LJH222-wq/zhinengxiaoche/_基于Arduino_nano的智能小车设计2V3-物料清单.pdf

焊接 顺序 | 器件名称 | 参数 | 位号 | 商城编号 | 数量 | 备注
1 | 直插电阻330Ω | 1/4W-330Ω | R9,R10,R7,R8,R11,R12 | C713986 | 6
2 | 直插电阻10KΩ | 1/4W-10kΩ | R1,R2、R4~R6,R13~R24 | C410695 | 17
3 | 发光二极管-红色 | 3mm 红色 | LED1 | C99771 | 1 | 长脚为正极
4 | 发光二极管-绿色 | 3mm 绿色 | LED4~LED7 | C330929 | 4 | 长脚为正极
5 | 发光二极管-白色 | 白色高亮 | LED2,LED3 | C331025 | 2 | 90度弯脚，长脚为正极
6 | 开关二极管 | 1N4007 | D1,D2 | C402311 | 2 | 白色竖线为负极
7 | 三极管 | S8050 | Q1 | C2931492 | 1 | 管脚较密，注意不要短路
8 | 蜂鸣器 | 16Ω-50P4.0 | Buzzer1 | C2693580 | 1 | "+"处为正极
9 | 芯片底座 | DIP-8 | U12,U13 | - | 2 | 底座缺口位置与丝印对齐
10 | 比较器芯片XD393 | LM393P | U12,U13 | C561266 | 2 | 芯片缺口位置对齐底座缺口
11 | 可调电阻 | 3296W-1-103 | RP1~RP5 | C118954 | 5 | 调节旋钮与丝印对齐
12 | 光电传感器ITR9909 | ITR9909 | U8~U11 | C53399 | 4 | 位于PCB板背面， 白色灯方向与丝印对齐
13 | 电解电容 | 100uF | C1,C2 | C19504 | 2 | 长引脚为正极，短的为负极 有白色丝印条的是负极
14 | 散热片 | 15.5*10.5*24 | U1 | C108928 | 1 | 将芯片与散热片紧靠，用KM3*4螺 丝拧紧后成为一个整体。然后插入 电路板中进行焊接
15 | 电源芯片L7805CV | L7805CV | U4 | C111887 | 1
16 | 独立按键 | 6*6*4.5 | KEY1 | C2834896 | 1
17 | 拨动开关 | SK-12E12-G5 | SW1 | C136720 | 1
18 | 电池座 | 14500*2 | P1 | - | 1 | 先将电池座用M3*6螺丝和螺母固定 在电路板上，再焊接管脚
19 | XHB2.54带扣插座2P | XHB2.54 2P | H2、H3、H5、H6 | C7429614 | 4 | 注意缺口方向
20 | 单排排母 | 2.54mm，1*15P | U7 | C2932676 | 3 | 先将Arduino nano核心板插入2个排 母，再将排母底端插入电路板中进 行焊接
21 | Arduino nano开发板 | Arduino nano | U7 | | 1
22 | 单排排母6P | 2.54mm，1*6P | BLUETOOTH | | 1 | 先焊好排母，再插入蓝牙模块（插 入时注意管脚名称对齐）
23 | 蓝牙模块 | HC-05 | BLUETOOTH | | 1
24 | 单排排母4P | 2.54mm，1*4P | H4、JP2 | | 2
25 | 超声波测距模块 | HC-SR04 | H4 | | 1
26 | 驱动芯片RZ7899 | RZ7899 | U2、U3、U5、U6 | C92373 | 4 | 圆点为第1引脚
27 | 电机排线 | XHB2.54*2P,5mm | | | 4 | 焊接时间不宜过长
28 | 电机座 | | ASS_1,ASS_2,ASS_3,ASS_4 | | 4 | 用M2*5螺丝、螺母（各8个）固定
29 | 锂电池 | 14500 | | | 2
30 | 锂电池充电器 | 4.2V/1A | | | 1
31 | 橡胶车轮 | 43mm | | | 4
32 | 直流电机 N20 | 直型，6V，100转 | | | 4
33 | 智能小车底板 | | | | 1

## 轮式智能小车物料清单
