LJH222-wq/zhinengxiaoche/(list of files, cad)

Other CAD files:
装配体2/装配体2.SLDASM
装配体2/3D外壳.SLDPRT
