LJH222-wq/zhinengxiaoche/SCH_智能小车_2025-12-19.pdf

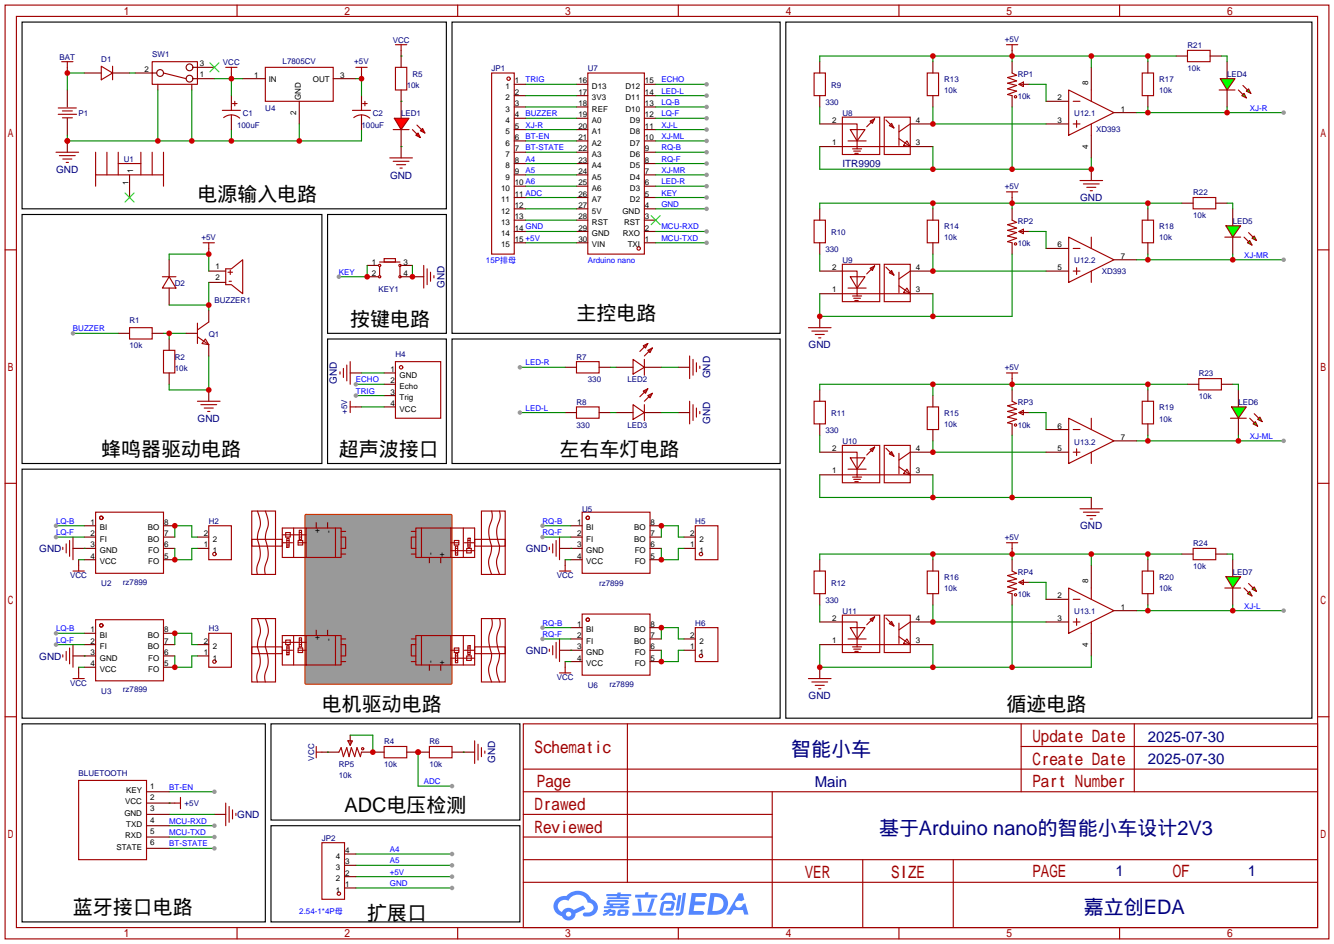
[picture p17: page 1]
