LJH222-wq/zhinengxiaoche/11号-硬件设计文件/SCH_Schematic1_2026-01-04.pdf

## 电源输入电路

10 10 11 11 12 12 13 13 14 14 15 15

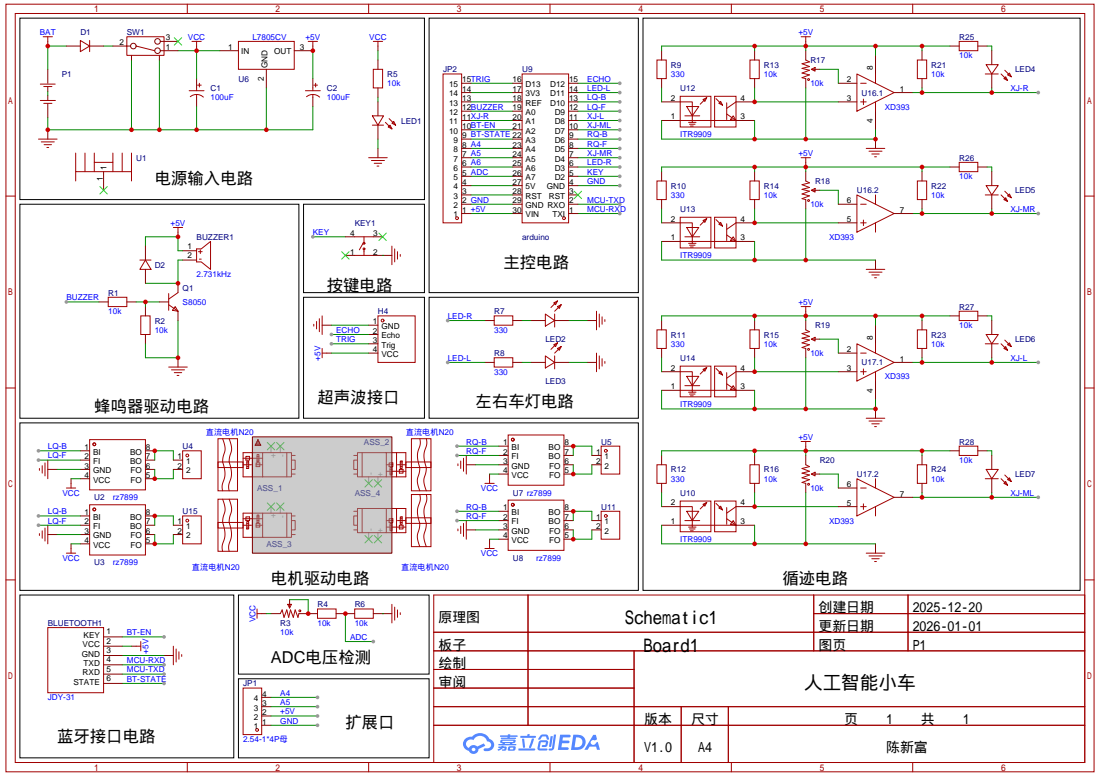
[picture p1: page 1]

原理图 | Schematic1 | 创建日期 | 2025-12-20

更新日期 | 2026-01-01

板子 | Board1 | 图页 | P1
绘制 | | 人工智能小车
审阅

V1.0 | A4 | 陈新富
