LJH222-wq/zhinengxiaoche/PCB_智能小车_2025-12-15.pdf

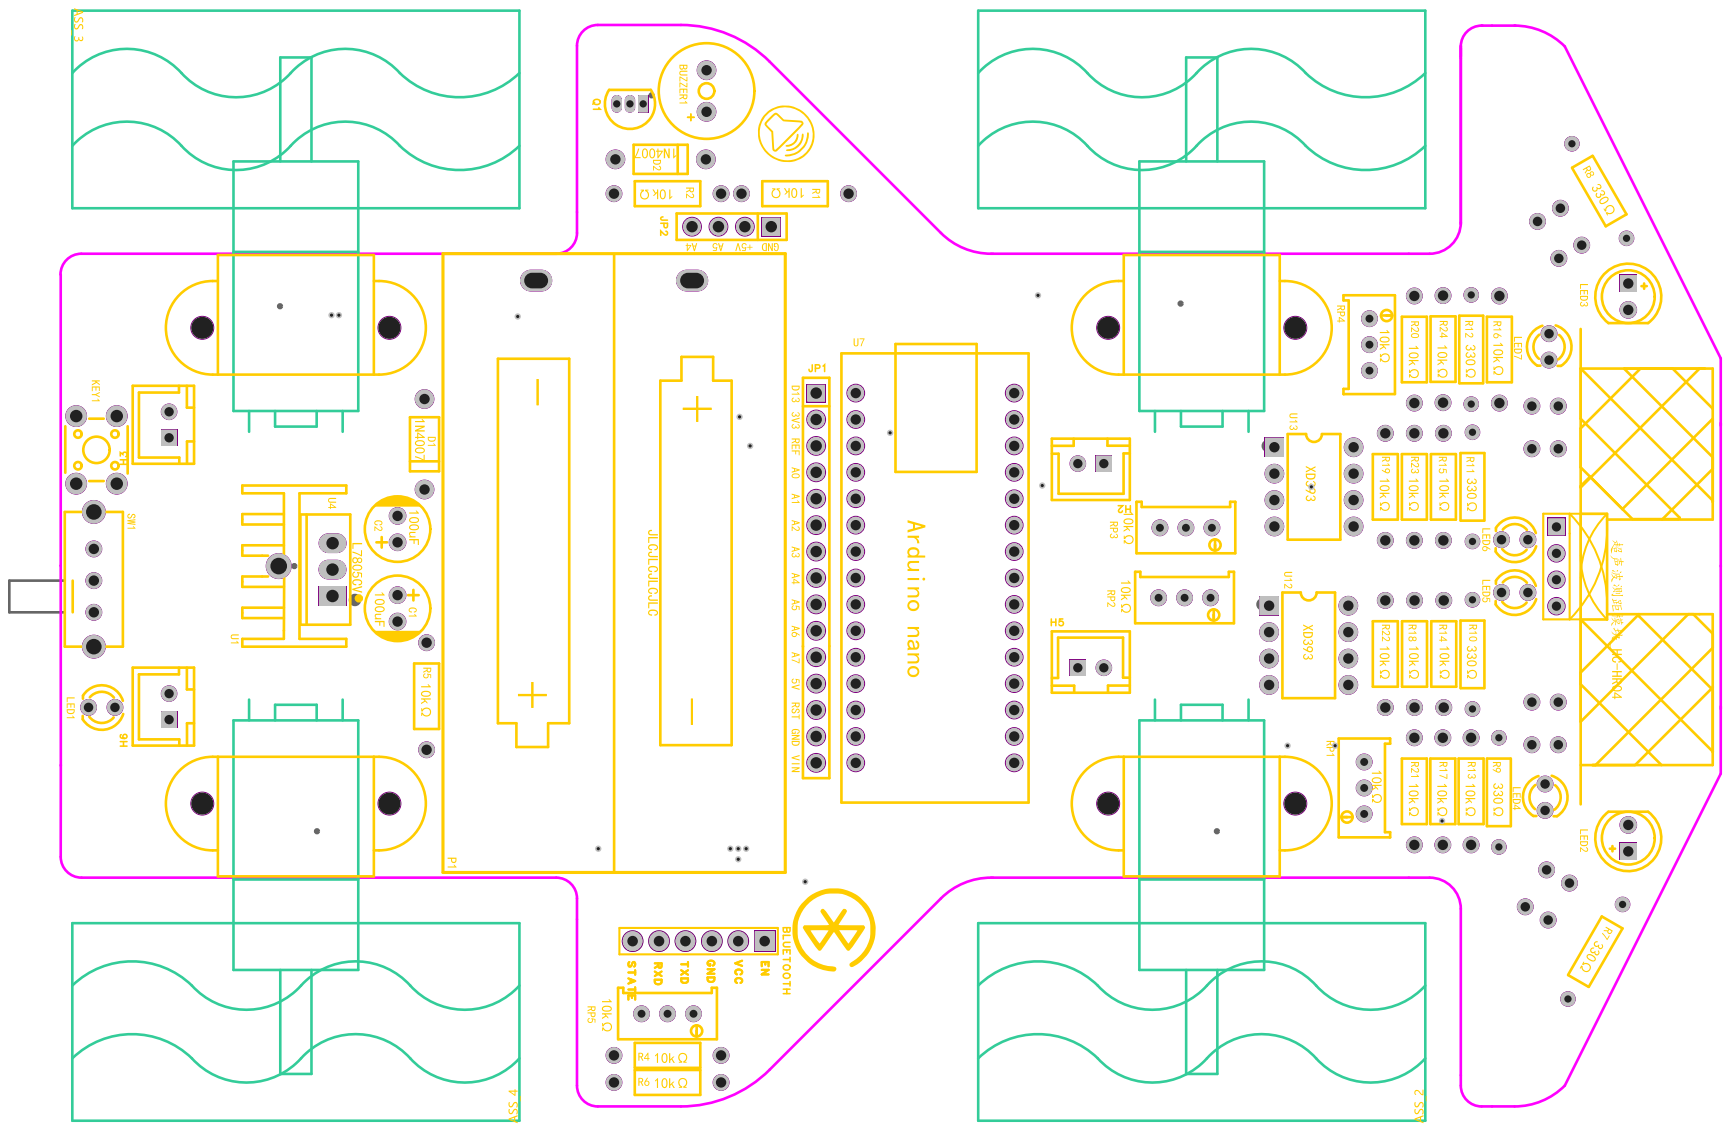
[picture p2: page 1]

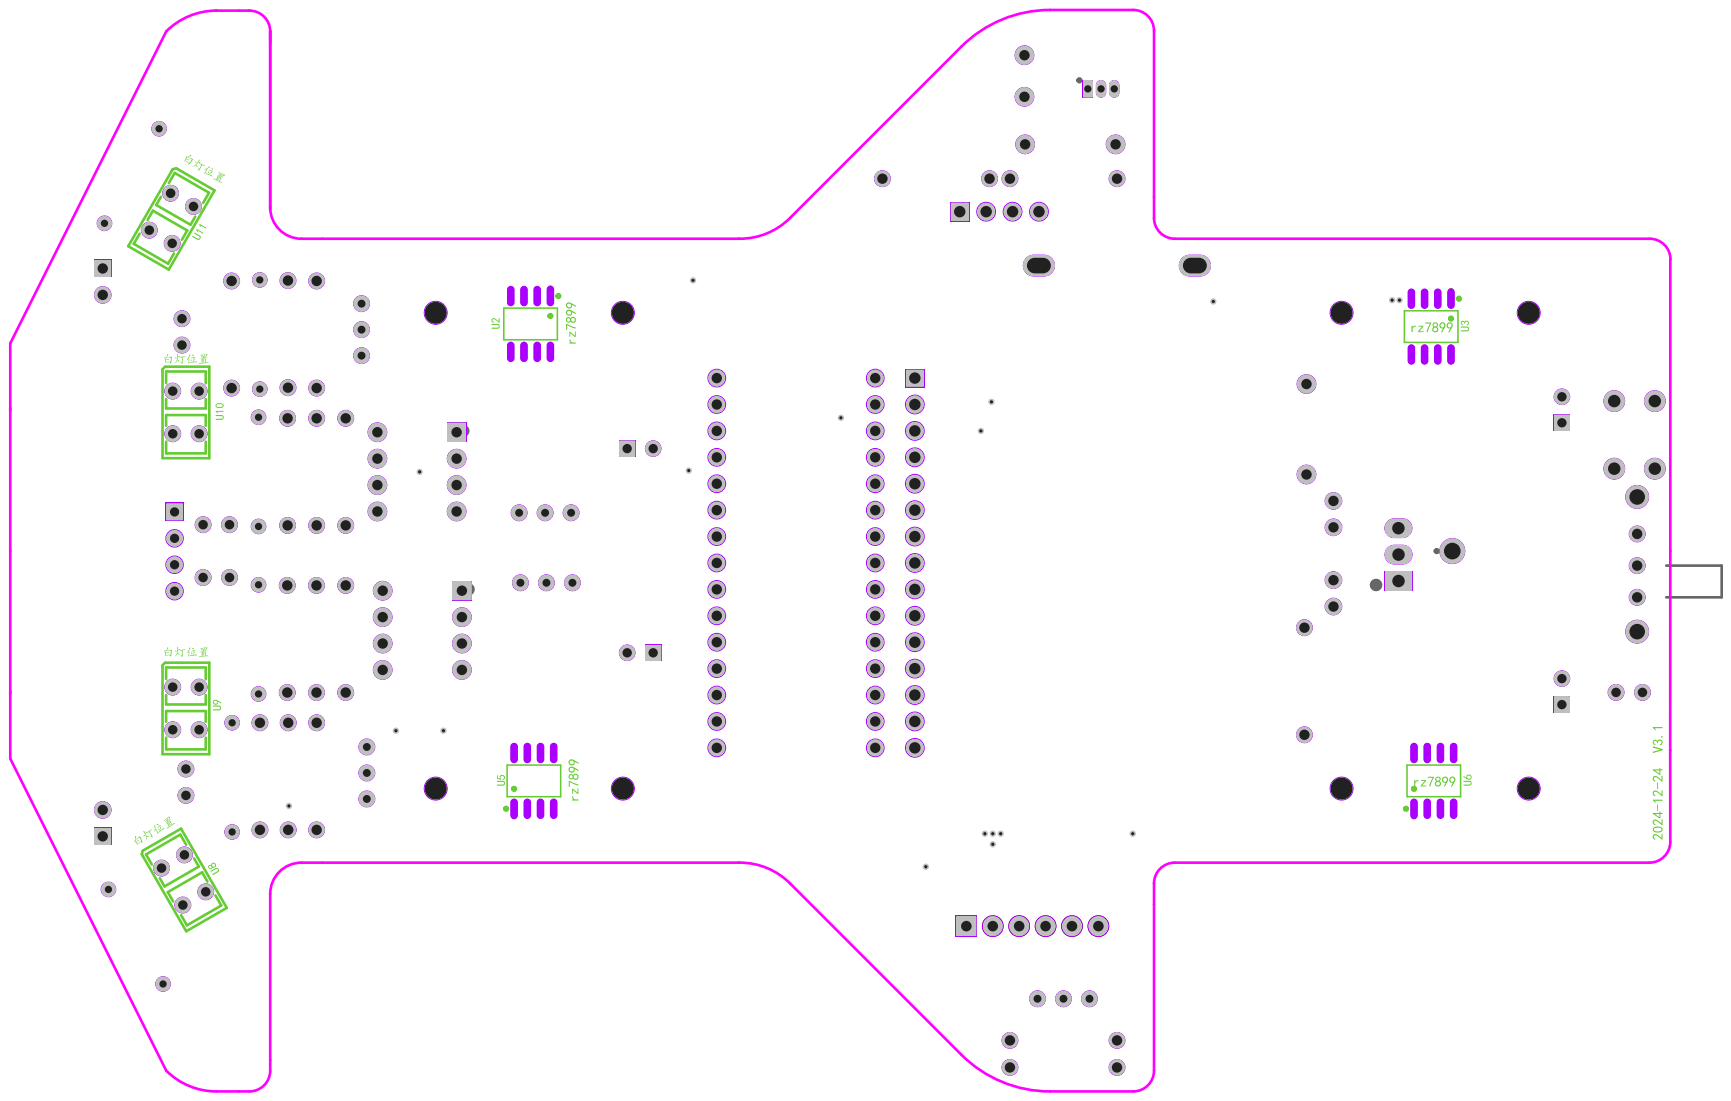
[picture p3: page 2]

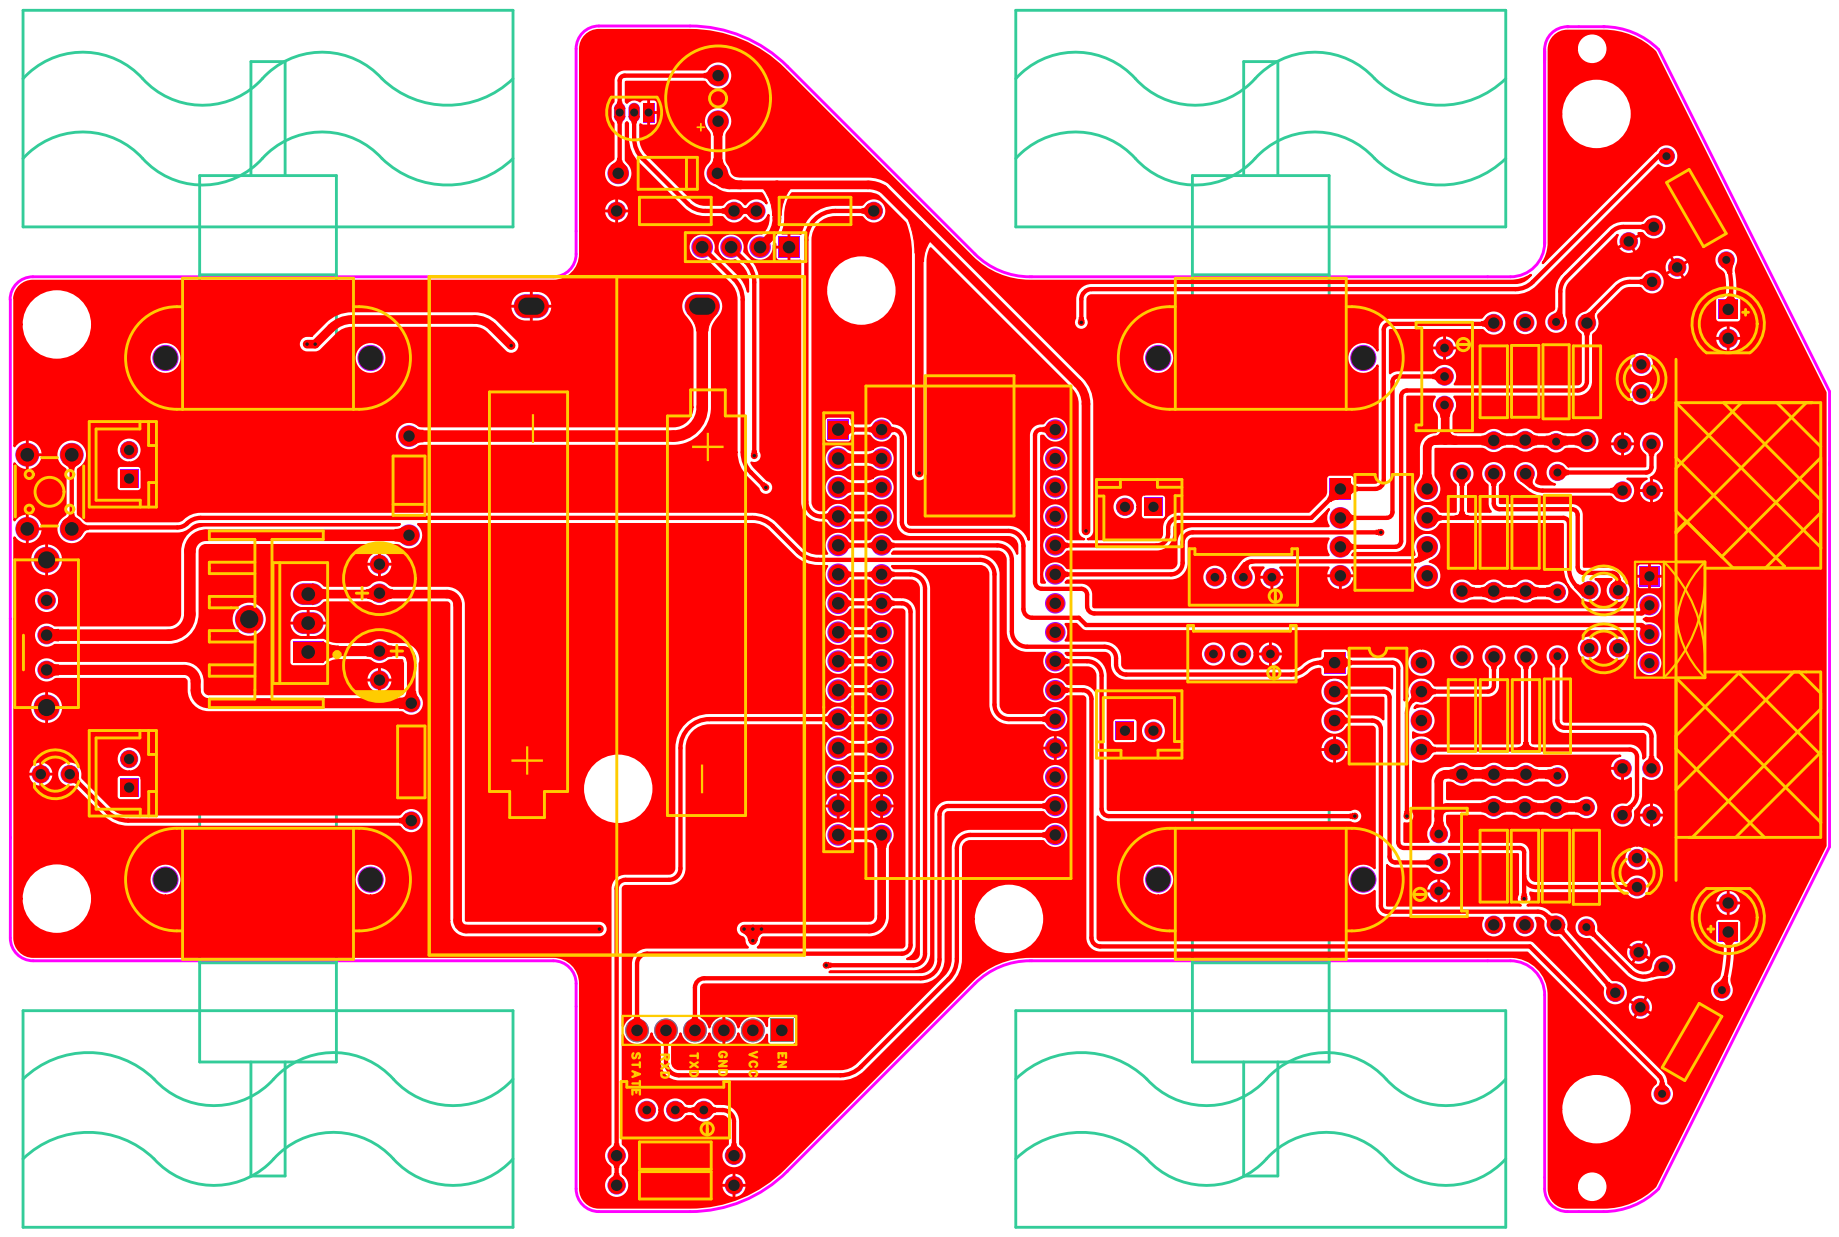
[picture p4: page 3]

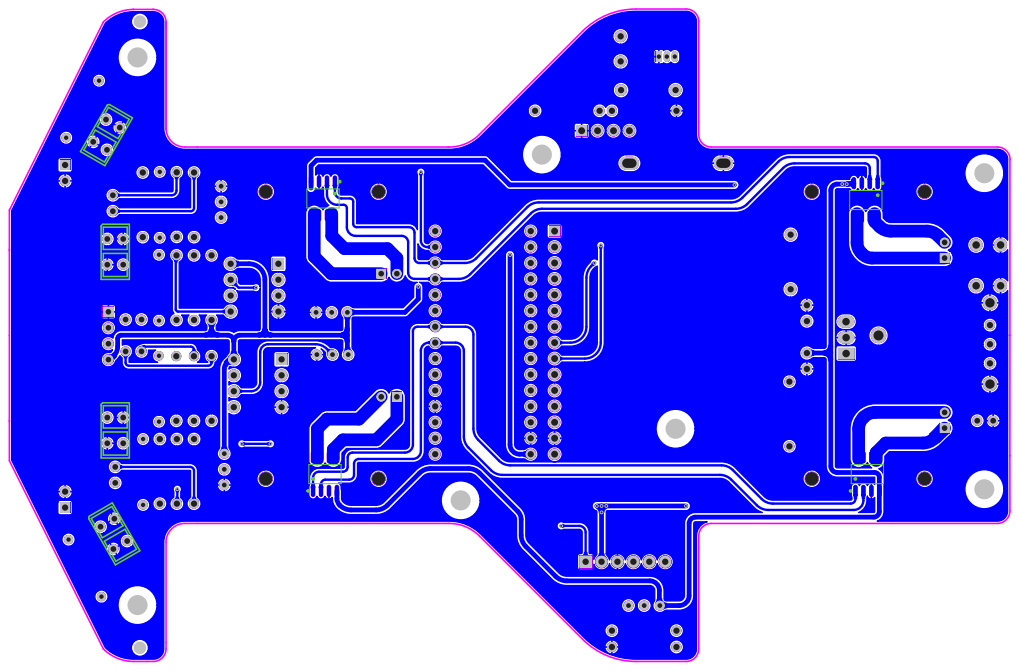
[picture p5: page 4]

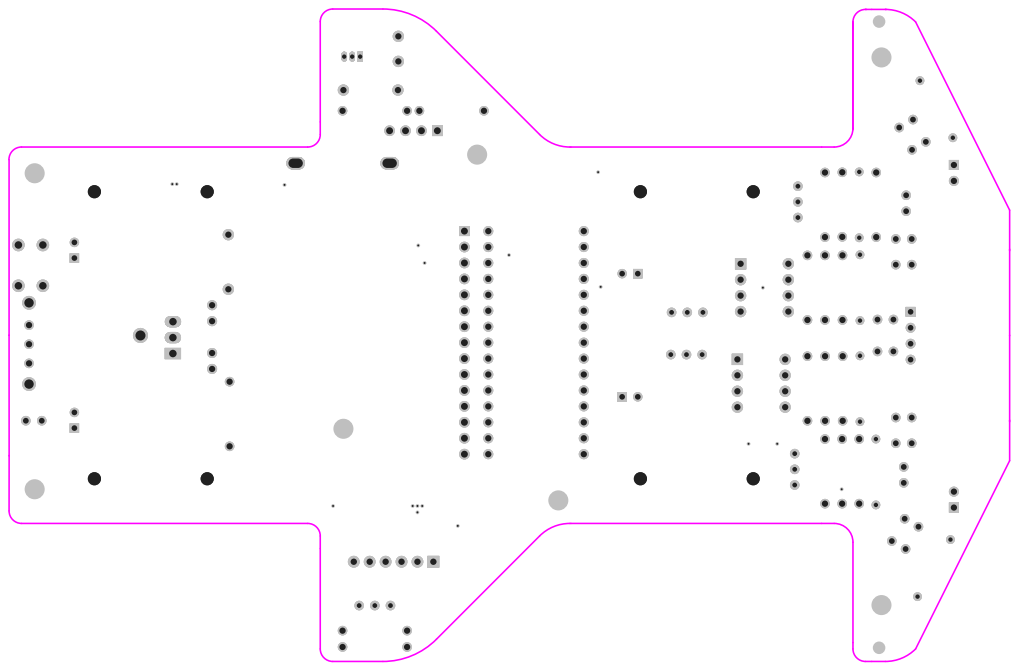
[picture p6: page 5]

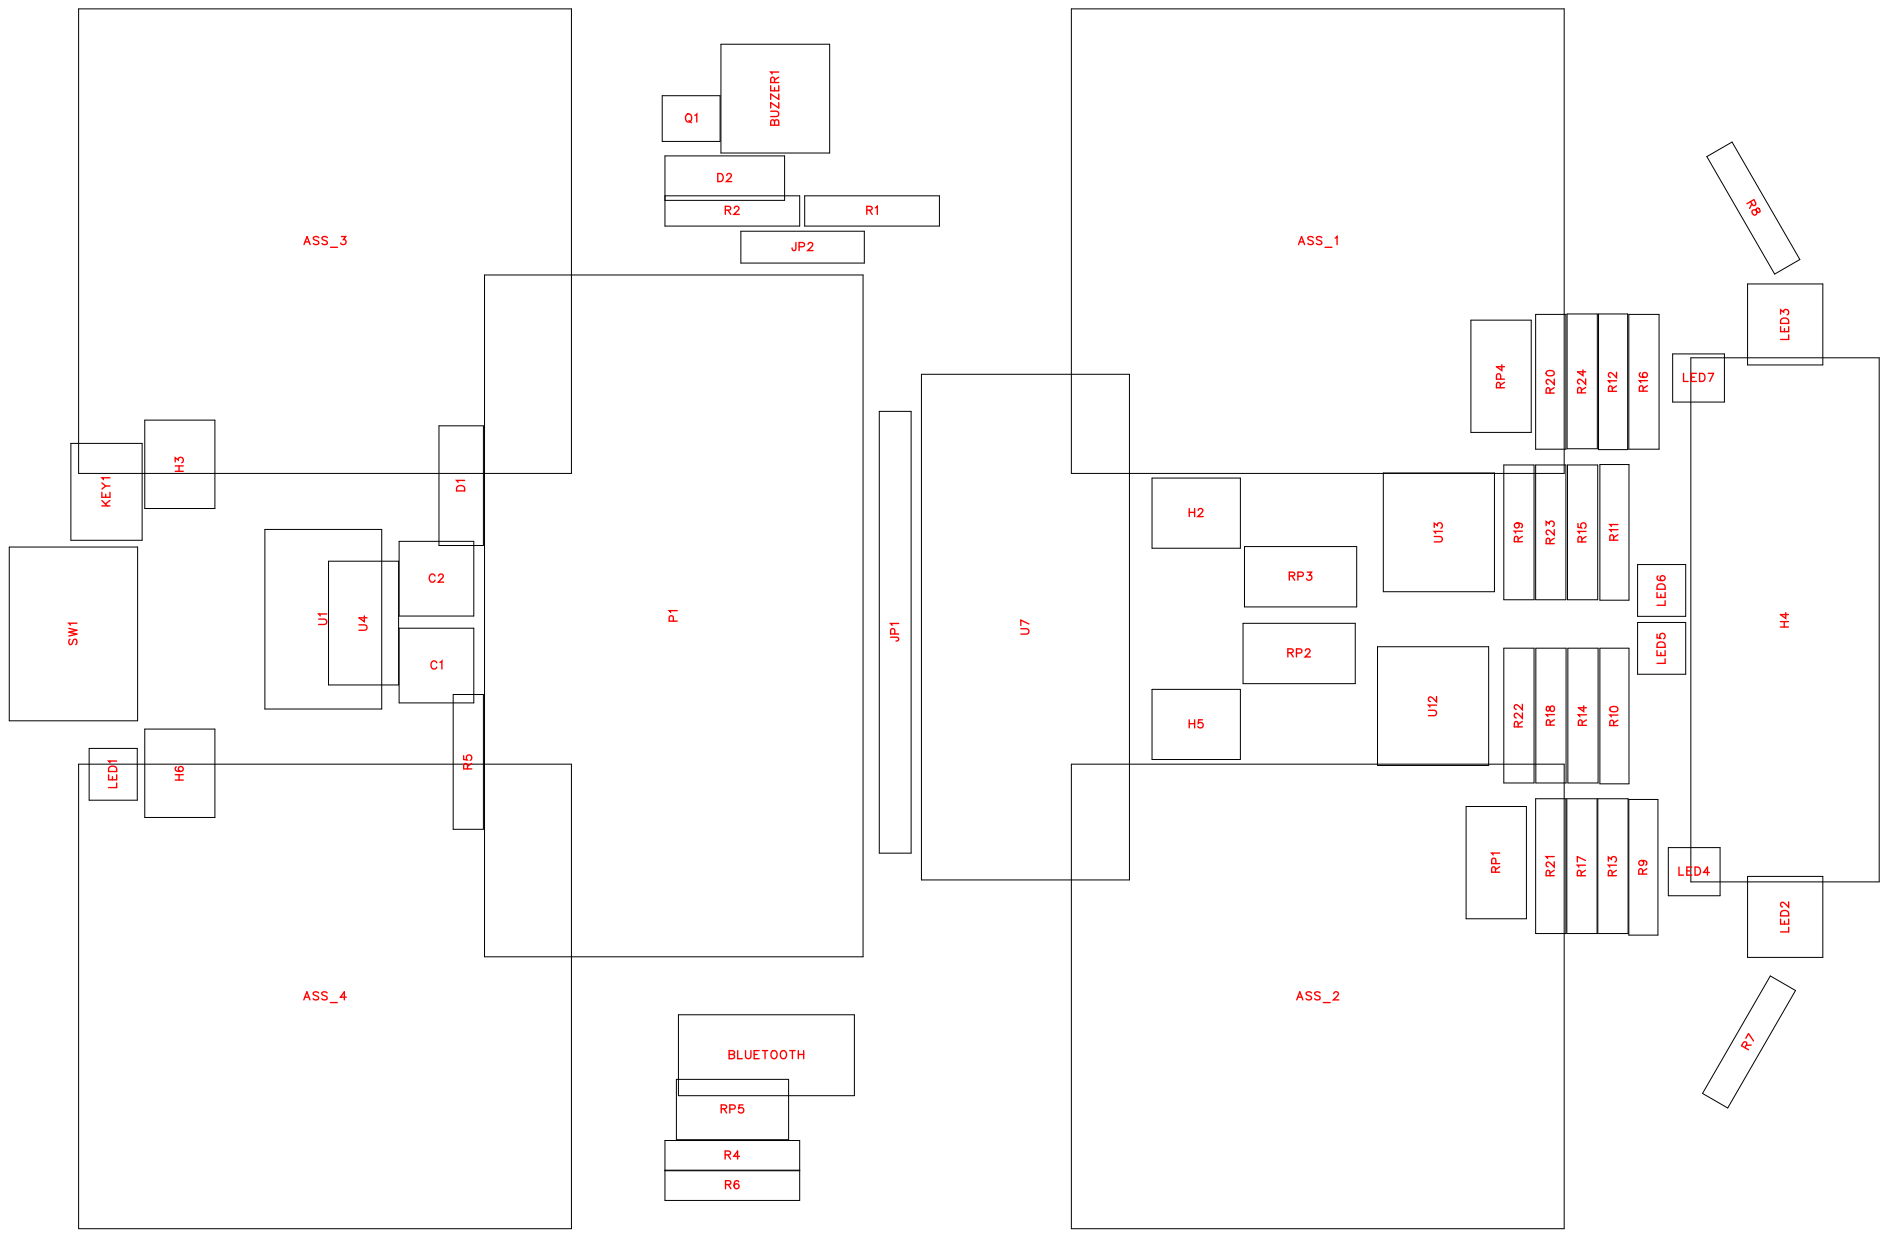
[picture p7: page 6]

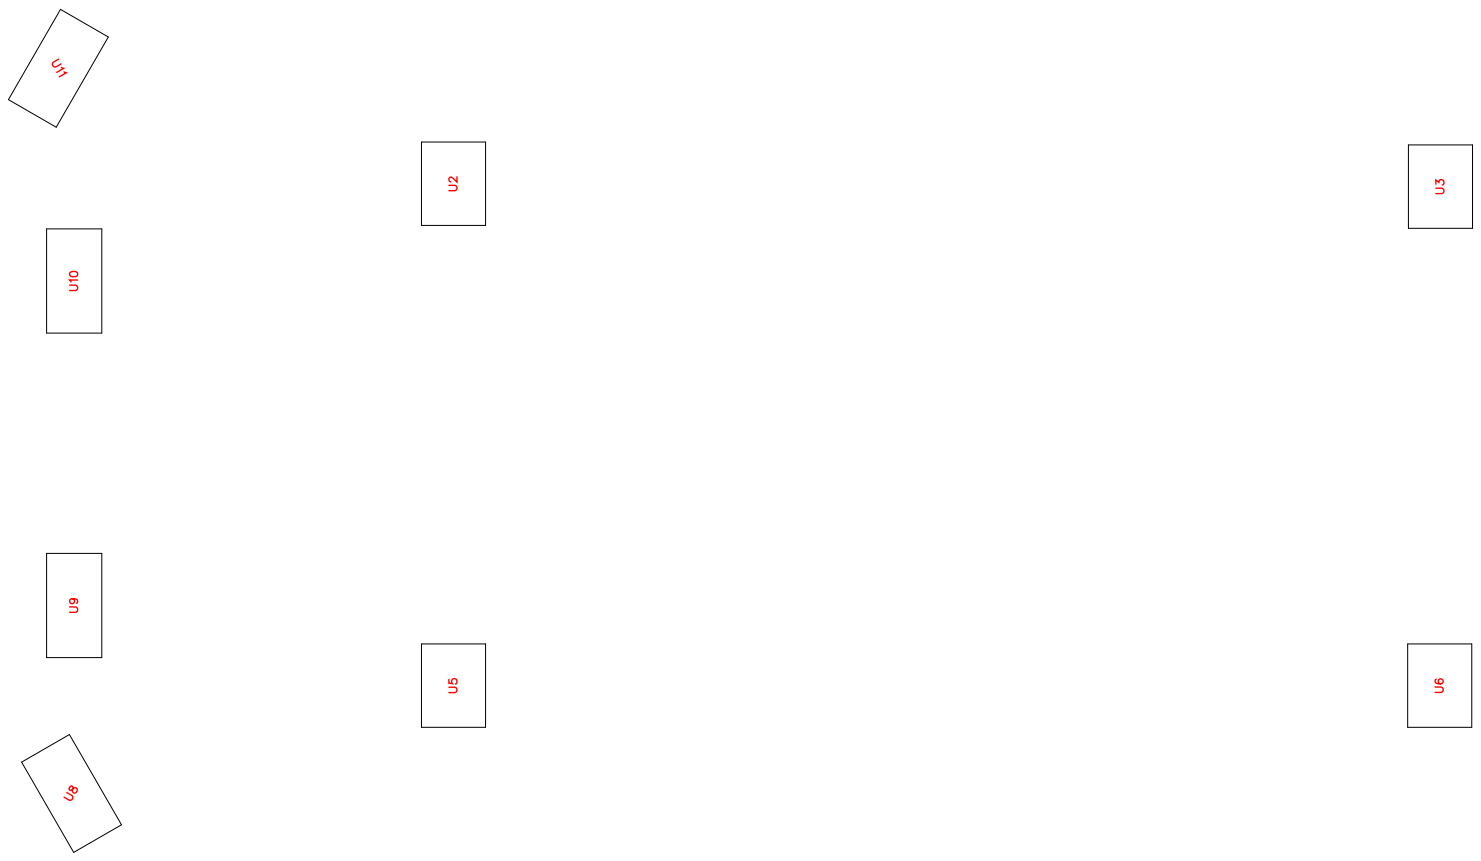
[picture p8: page 7]

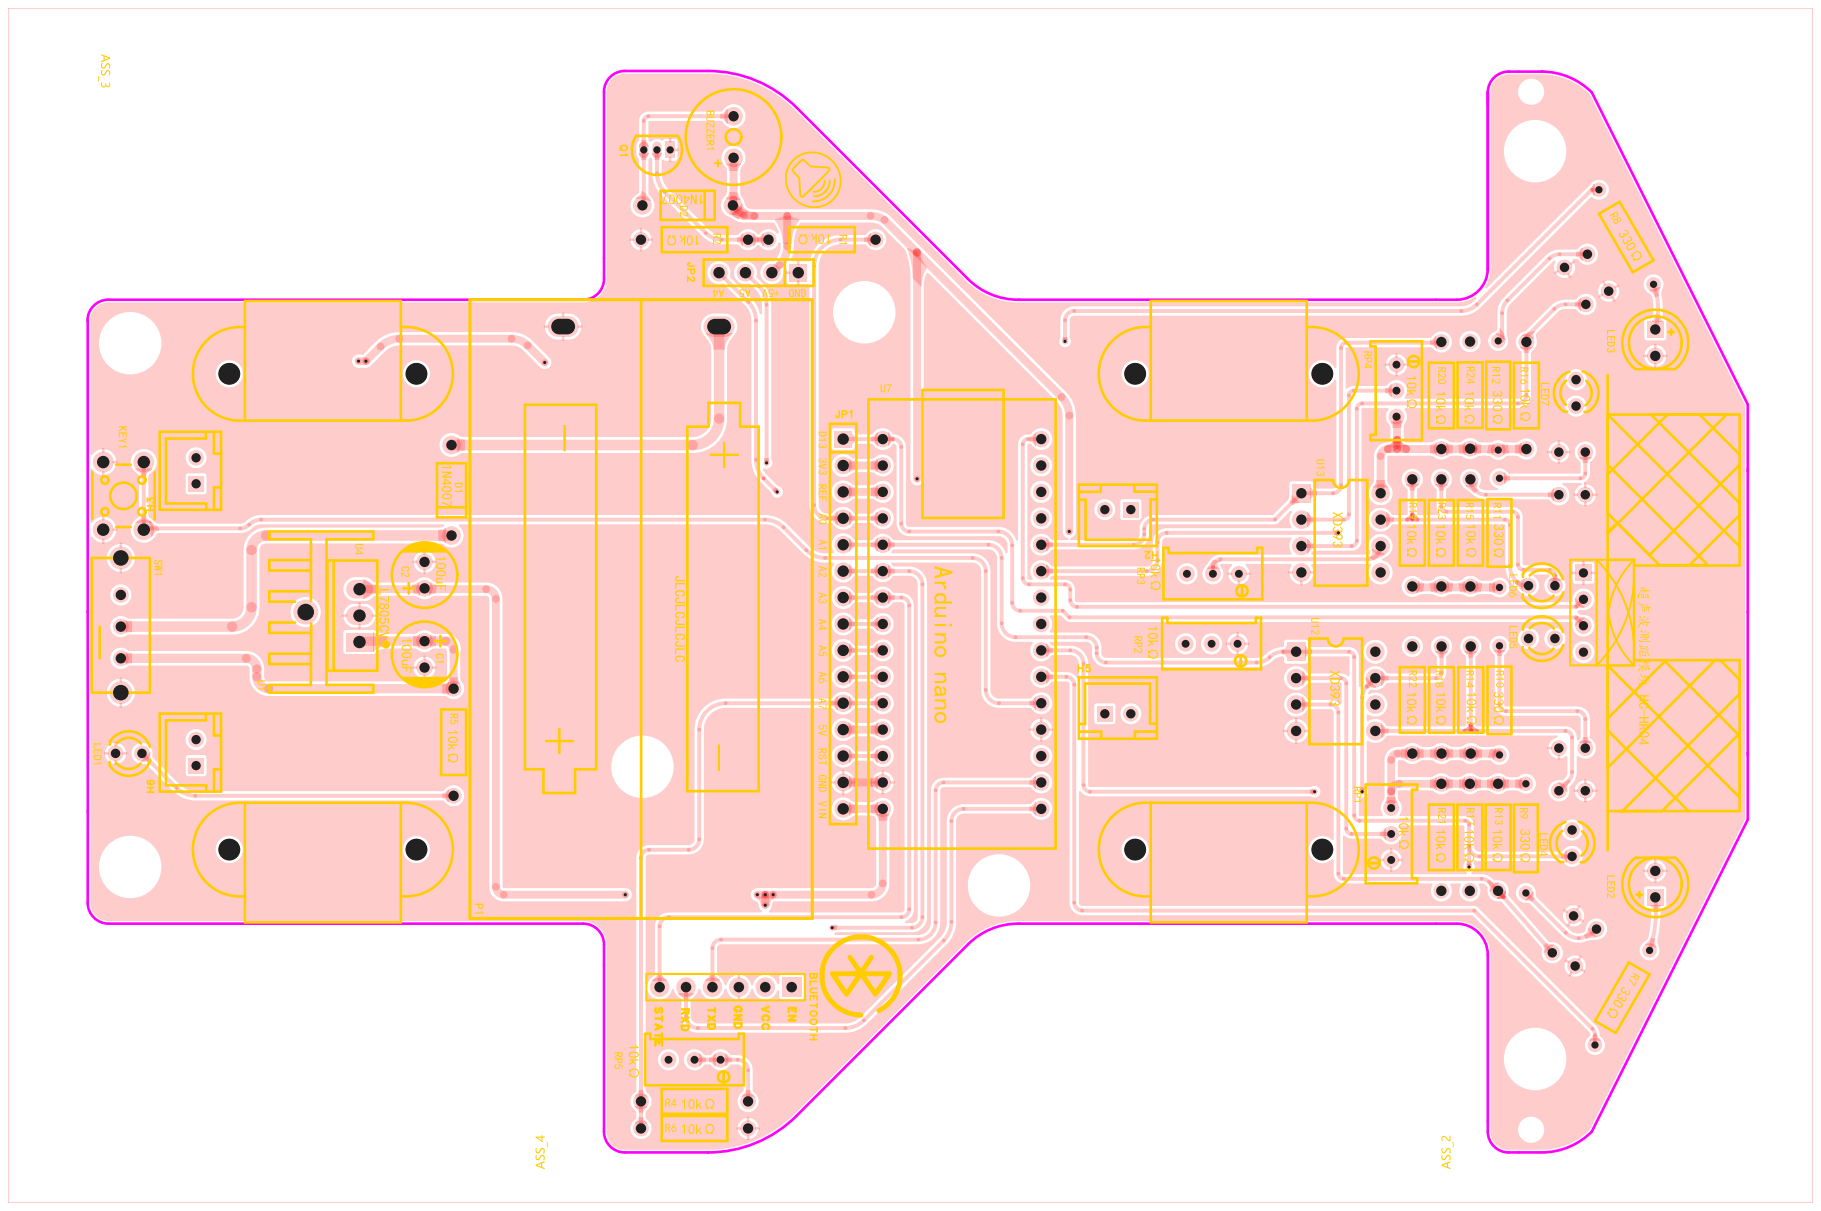
[picture p9: page 8]

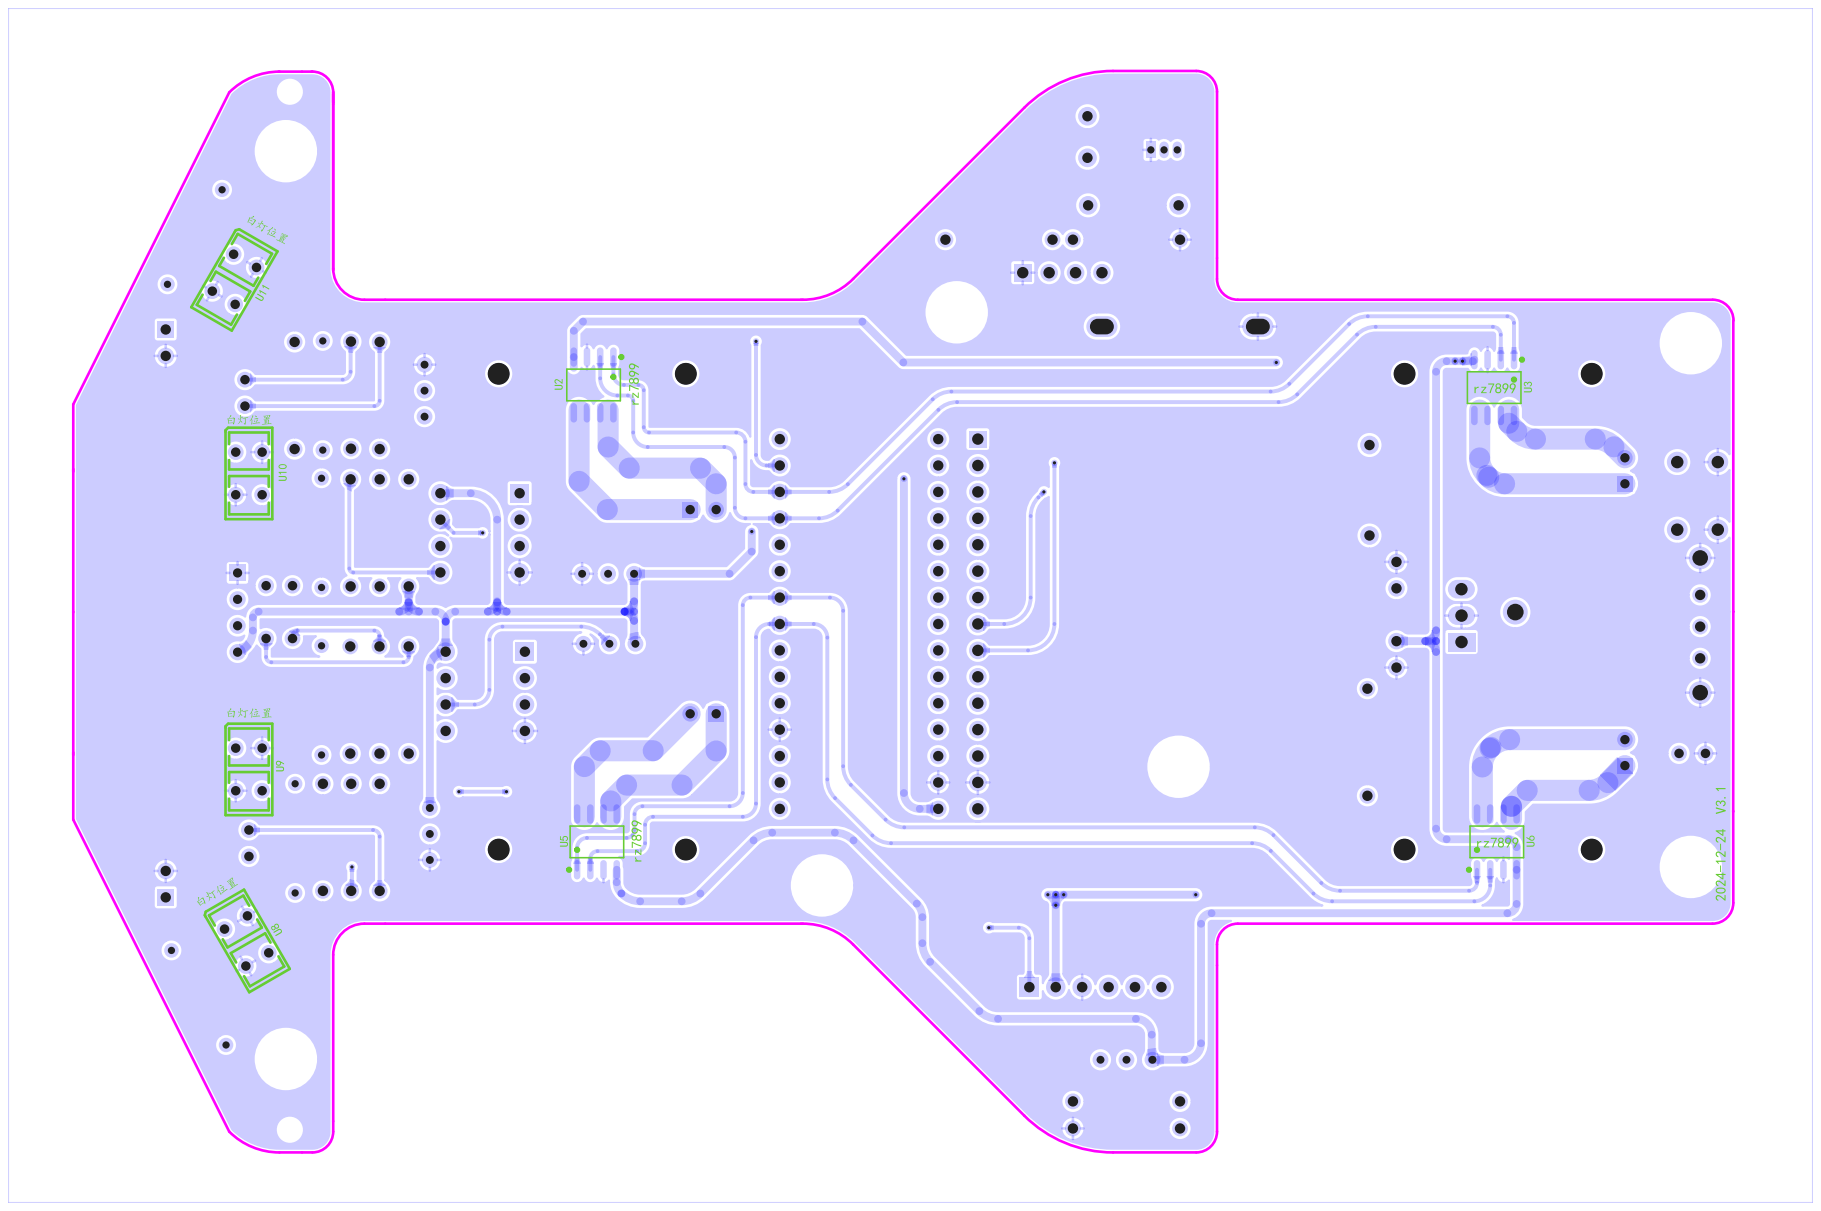
[picture p10: page 9]

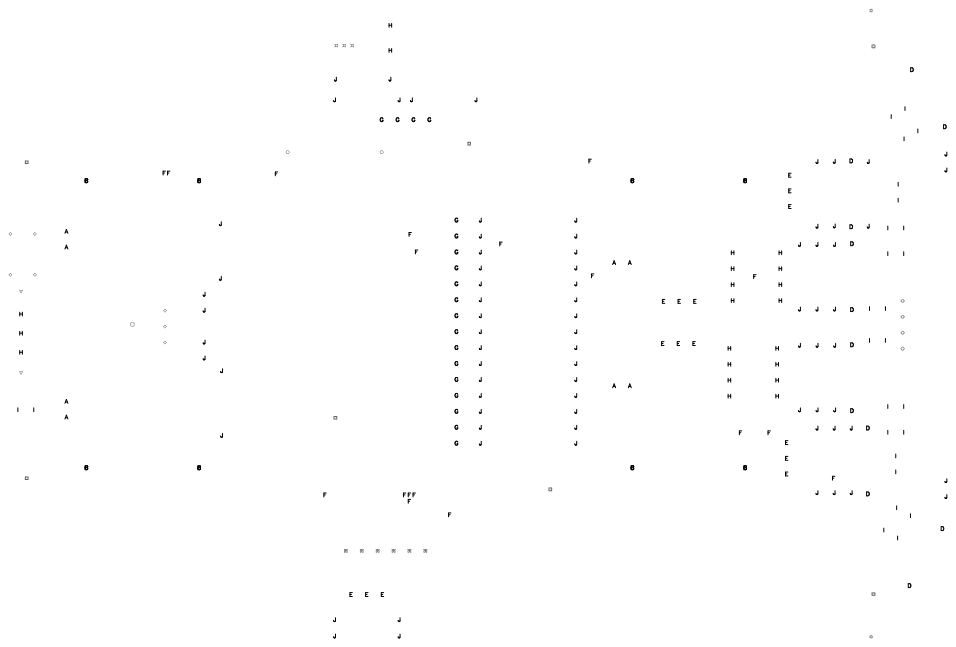
[picture p11: page 10]

No. | Quantity | Comment | Designator | Footprint | Value | Manufacturer Part | Manufacturer | Supplier Part | Supplier
1 | 4 | 直流电机N20 | ASS_1,ASS_2,ASS_3,ASS _4 | 直流电机N20 _水平装配
2 | 1 | JDY-31 | BLUETOOTH | HC-05 PCB
3 | 1 | SEA-0955Y-0527-16 -5 0P4.0 | BUZZER1 | BUZ-TH_BD 9.2-P4.00-D0 .6-FD | | SEA-0955Y-0527-16 -5 0P4.0 | S&S(海旭) | C2693580 | LCSC
4 | 2 | 100uF | C1,C2 | CAP-TH_BD 6.3-P2.50-D1 .0-FD | 100uF | KM107M035 E11RR0VH2 FP0 | CX(承兴) | C19504 | LCSC
5 | 2 | 1N4007 | D1,D2 | DO-41_BD2. 4-L4.7-P8.70 -D0.9-RD | | 1N4007 | LGE(鲁光) | C402311 | LCSC
6 | 4 | ZX-HA2.54-2 PZZ | H2,H3,H5,H6 | CONN-TH_2 P-P2.50_HC-XH-2A-G | | | Megastar(兆 星) | C7429614 | LCSC
7 | 1 | 超声波测距模 块_HC-HR04 | H4 | HC-HR04
8 | 1 | 15P排母 | JP1 | HDR-TH_254 1FV-15P-B | | 15P排母 | HanElectricit y(瀚源) | C25503121 | LCSC
9 | 1 | 2.54-1*4P母 | JP2 | HDR-TH_4P-P2.54-V-F | | 2.54-1*4P母 | BOOMELE( 博穆精密) | C2718488 | LCSC
10 | 1 | Key_TH_6x6 x4.5 | KEY1 | KEY-TH_4P-L6.0-W6.0-P 3.90-LS6.5 | | | | C2834896
11 | 1 | LED_TH-R_3 mm | LED1 | LED-TH_BD 3.0-P2.54-FD | | | | C99771 | 立创商城
12 | 2 | TJ-L5FCMY GTDLSFLC6 TW-A5 | LED2,LED3 | LED-TH_BD 5.8-P2.54-FD | | TJ-L5FCMY GTDLSFLC6 TW-A5 | TOGIALED( 台湾统佳) | C331025 | LCSC
13 | 4 | LED_TH-G_3 mm | LED4,LED5,LED6,LED7 | LED-TH_BD 3.0-P2.54-FD | | | | C330929 | 立创商城
14 | 1 | 14500*2 插针电池座 | P1 | 14500*2 插针
15 | 1 | S8050 | Q1 | TO-92-3_L5. 1-W4.1-P1.2 7-L | | S8050 | Slkor(萨科微) | C2826359 | LCSC
16 | 17 | 10k | R1,R2,R4,R5,R6,R13,R14, R15,R16,R17,R18,R19,R20 ,R21,R22,R23,R24 | RES-TH_BD 2.4-L6.3-P10. 30-D0.6 | 10k | RN 1/4W 10K F T/B A1 | Tyohm(幸亚 电阻) | C410695 | LCSC
17 | 6 | 330 | R7,R8,R9,R10,R11,R12 | RES-TH_BD 2.3-L6.5-P10. 50-D0.5 | 330 | MF1/4W-330 ±1%T52 | 华星机电 | C713986 | LCSC
18 | 5 | 10k | RP1,RP2,RP3,RP4,RP5 | RES-ADJ-TH _3P-L10.0-W 10.0-P2.50-L | 10k | 3296W-1-103 | BOCHEN(博 晨) | C118954 | LCSC
19 | 1 | SK-12E12-G 5 | SW1 | SW-TH_SK-1 2E12-G5 | | SK-12E12-G 5 | 韩国韩荣 | C136720 | LCSC

20 | 1 | 散热片15.5*1 0.5*24 带针 | U1 | HEATSINK-T H_L15.5-W1 0.5-XSD1226 -005 | 散热片15.5*1 0.5*24 带针 | XSD(鑫顺达 ) | C108928 | LCSC
21 | 4 | rz7899 | U2,U3,U5,U6 | SOP-8_L4.9-W3.9-P1.27-LS6.0-BL | rz7899 | RZ 睿智微 | C92373 | LCSC
22 | 1 | L7805CV | U4 | TO-220-3_L1 0.0-W4.5-P2. 54-L | L7805CV | ST(意法半导 体) | C111887 | LCSC
23 | 1 | Arduino nano | U7 | COMM-TH_A 000005 | Arduino nano | arduino | C19189484 | LCSC
24 | 4 | ITR9909 | U8,U9,U10,U11 | OPTO-TH_IT R9909 | ITR9909 | EVERLIGHT( ) 台湾亿光 | C53399 | LCSC
25 | 2 | XD393 | U12,U13 | DIP-8_L9.7-W6.4-P2.54-LS7.6-BL | XD393 | XINLUDA( 信 ) 路达 | C561266 | LCSC
