LJH222-wq/zhinengxiaoche/SCH_智能小车_2025-12-19.pdf

# 电源输入电路
